denischumak/diplom_spbu/(commit log)

2026-07-10 init repo
    [sample_00001_raw.csv, sample_00002_raw.csv, sample_00003_raw.csv, sample_00004_raw.csv, sample_00005_raw.csv, sample_00006_raw.csv, sample_00007_raw.csv, sample_00008_raw.csv]
2026-07-10 Update README with software information for ESP32-C3
    Added section about software for ESP32-C3 with FreeRTOS.
